skilmartin18/pi-zero-eink-music-assistant-client/docs/backPlate.png

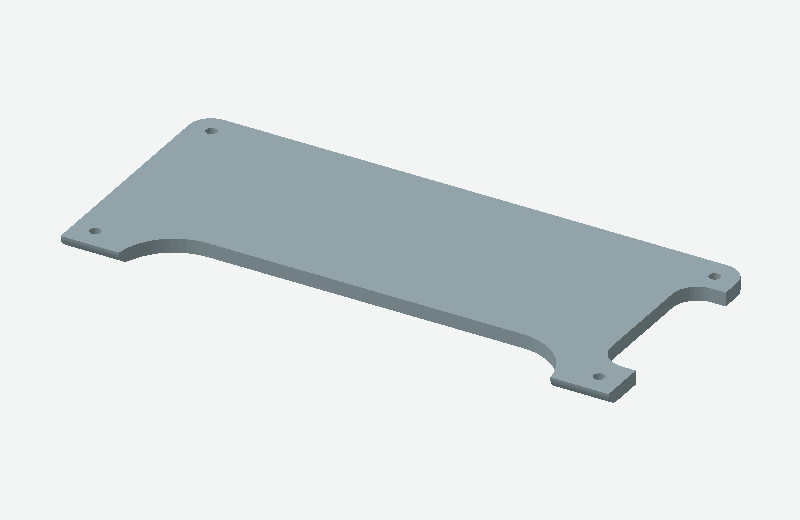
docs/backPlate.png
