skilmartin18/pi-zero-eink-music-assistant-client/docs/body.png

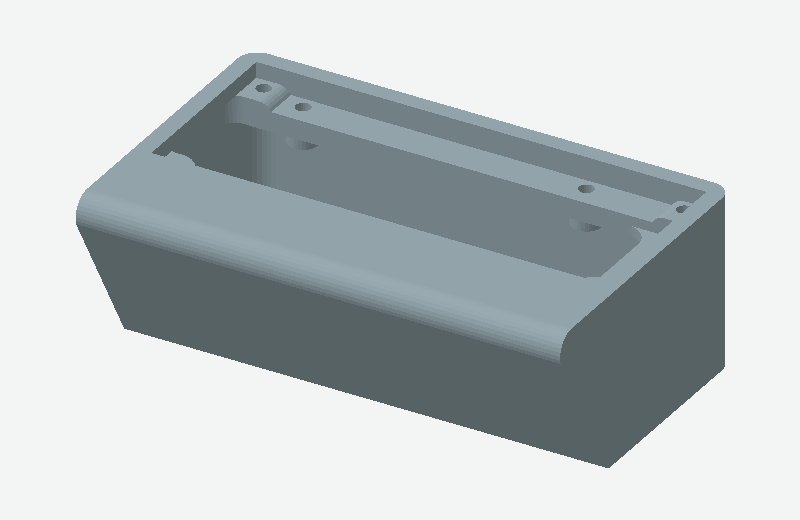
docs/body.png
