skilmartin18/pi-zero-eink-music-assistant-client/docs/frontPanel.png

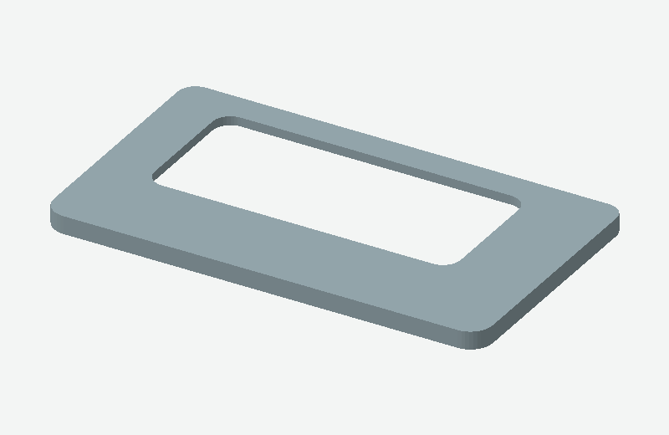
docs/frontPanel.png
