skilmartin18/pi-zero-eink-music-assistant-client/models/v1-big/frontPanel.stl

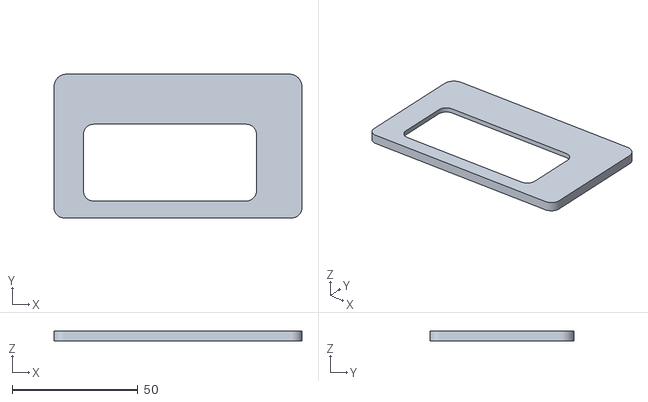
[picture p12: CAD file, 2026-11-07]
models/v1-big/frontPanel.stl
98.5 x 57.1 x 4.00
