skilmartin18/pi-zero-eink-music-assistant-client/models/v2-small/backPlate.stl

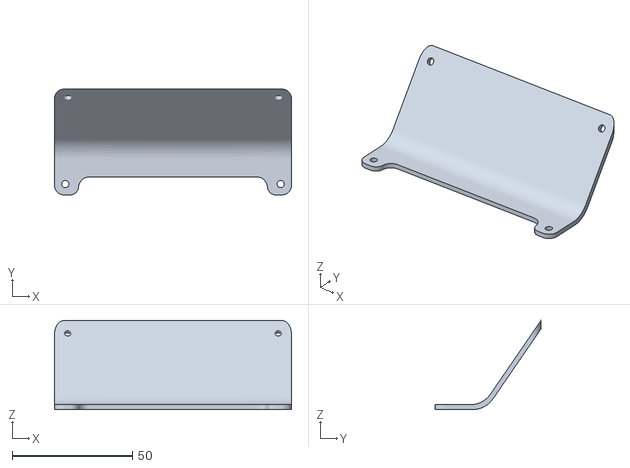
[picture p13: CAD file, 2026-11-10]
models/v2-small/backPlate.stl
98.5 x 44.0 x 37.0
