skilmartin18/pi-zero-eink-music-assistant-client/models/v1-big/backPlate.stl

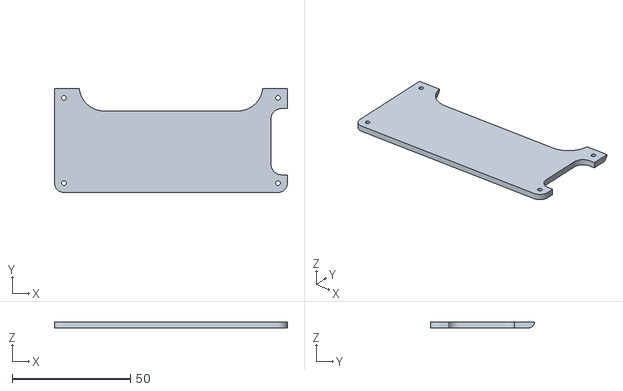
[picture p14: CAD file, 2026-11-07]
models/v1-big/backPlate.stl
98.5 x 44.0 x 2.50
