skilmartin18/pi-zero-eink-music-assistant-client/models/v2-small/body.stl

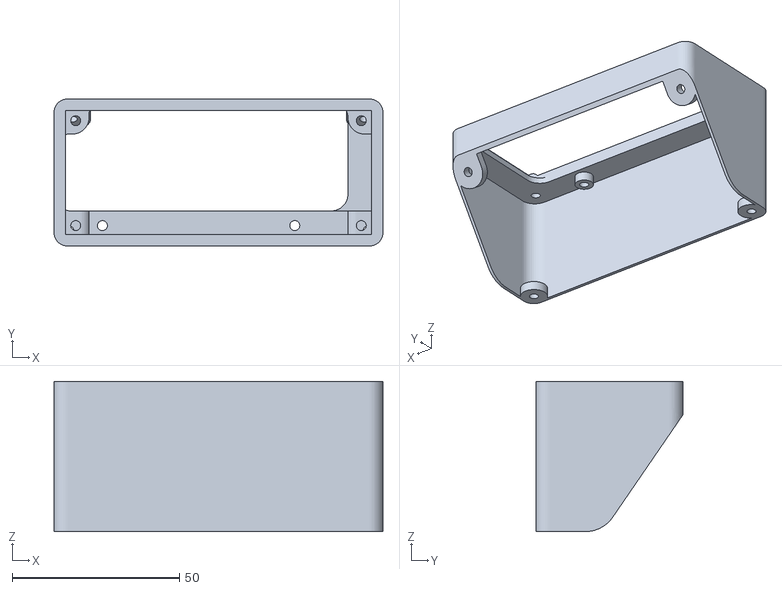
[picture p15: CAD file, 2026-11-10]
models/v2-small/body.stl
98.5 x 44.0 x 45.0
