skilmartin18/pi-zero-eink-music-assistant-client/models/v1-big/body.stl

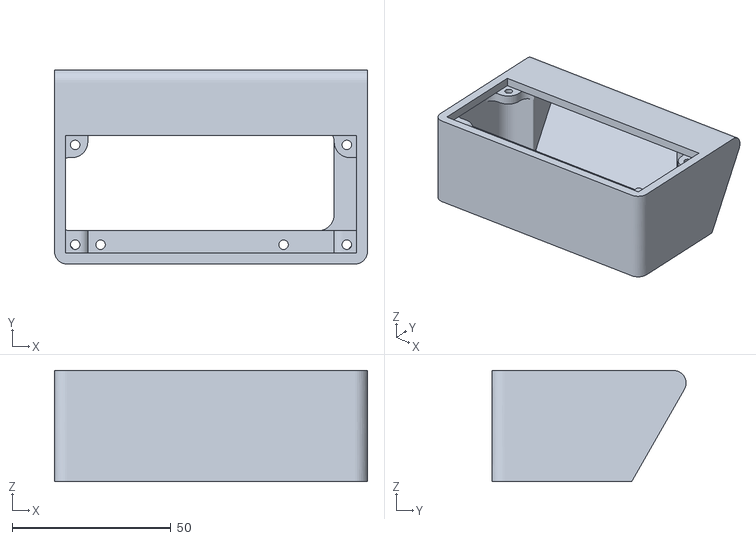
[picture p16: CAD file, 2026-11-07]
models/v1-big/body.stl
98.5 x 61.1 x 35.0
