skilmartin18/pi-zero-eink-music-assistant-client/models/v2-small/frontPanel.stl

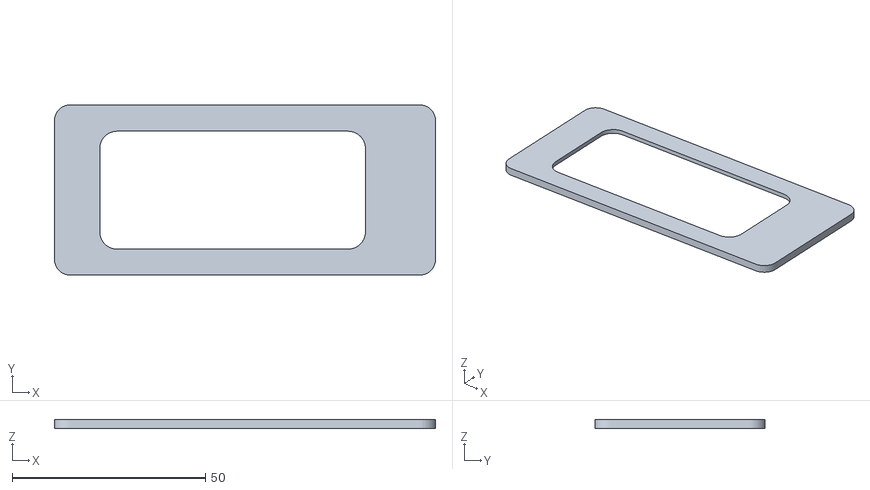
[picture p17: CAD file, 2026-11-10]
models/v2-small/frontPanel.stl
98.5 x 44.0 x 2.25
