skilmartin18/pi-zero-eink-music-assistant-client/(commit log)

2026-11-02 added switch for optional party-qr usage
2026-11-07 added case models and updated install script
    [backPlate.stl, body.stl, frontPanel.stl]
2026-11-10 added new models frfr
    [backPlate.stl, body.stl, frontPanel.stl]
